reilo/flip4fun-neopixel/README.md

# Ambilight multi-color effects for pinball machines

## Motivation and Summary

Goal of this project is to add multi-color ambilight effects to pinball machines. Instead of showing static colors the lighting effects should depend on the current gameplay situation such as the active mission, the currently running multiball or any other events.

The used hardware consists of LED strips which are attached below the cabinet and behind the backbox, both to the left and right side. The strips are controlled by a microcontroller, an Arduino Uno in this case.

The actual challenge of the project is to find out the current gameplay situation. Unfortunately pinball manufacturers do not provide any APIs for their machines. The only way is to read the state of coils, flashers, and lamps by sensors. For flashers and coils this could be  done directly by measuring the electric current from the  board connectors. Accessing the multiplexed lamp matrix however seems to be hardly feasible.

As I am not an electronics engineer and won't risk to disturb the sensitive pinball electronics I decided to simply read the state of lamps and flashers from below the playfield using photo sensors.

Version 1.0 is now ready - check out this [YouTube video](https://www.youtube.com/watch?v=rxIm8FgeuAI) to watch my Star Trek Pro pinball machine with ambilight.

## Hardware

### LED strips

The Neopixel multi-color LED strips allow controlling each pixel individually and the strips can easily be programmed using a microcontroller with help of the Neopixel C++ library.

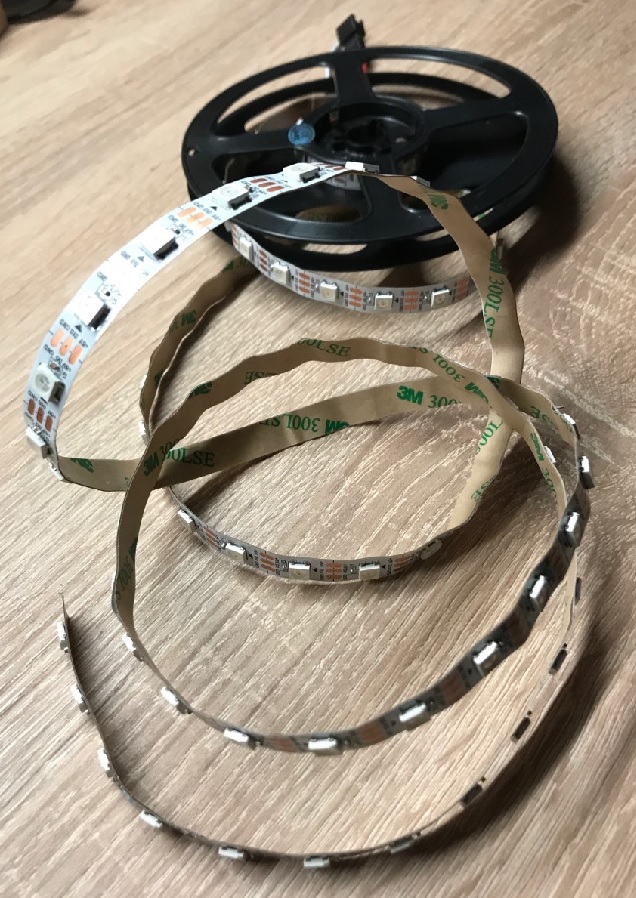
[picture p1: pictures/Neopixel-Strip.jpg]
Neopixel LED Strip


Two long LED strips are attached to either side below the cabinet and two shorter LED strips to either side behind the backbox.

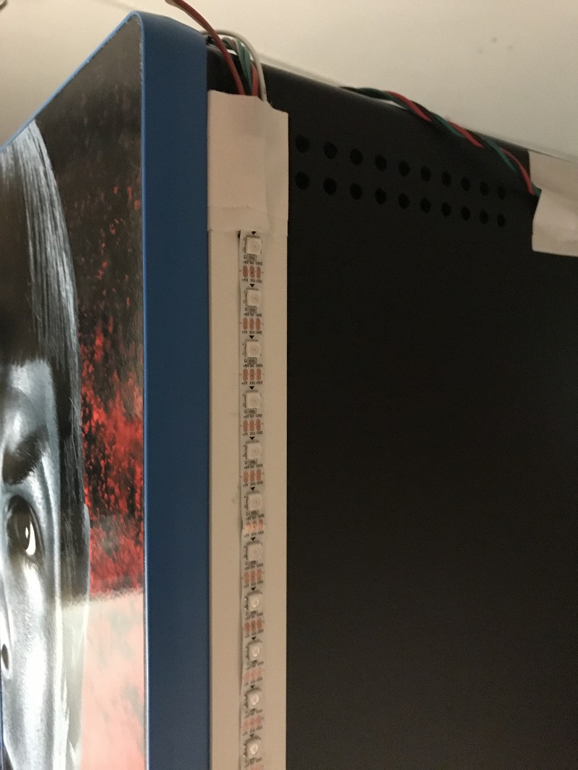
[picture p2: pictures/Backbox-LED-Strip.jpg]
Backbox LED Strip


The backbox strips are wired through the little hole on the top of the backbox which is present on all newer Stern pinball machines. The undercab strips are wired through one of the holes at the rear of the cabinet.

The DIN (digital in) port is directly connected to a digital output port of the microcontroller. The power supply ports 5VDC and GND are connected to the 5V power supply unit.

### Photo Sensors

LM393 boards are used which are integrated with a photo sensor and a potentiometer.

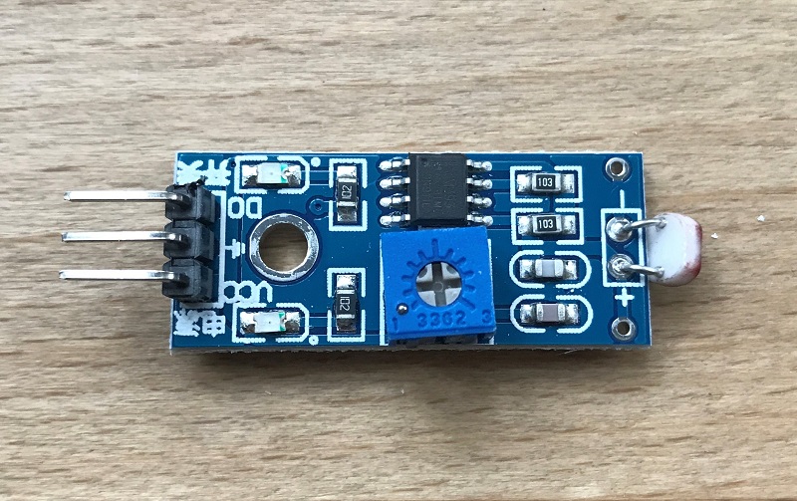
[picture p3: pictures/LM393-Photo-Sensor.jpg]
LM393 Photo Sensor


The sensor is placed below the playfield beneath the insert whose lighting state should be read. The example shows how sensors were placed below the mission inserts of Star Trek.

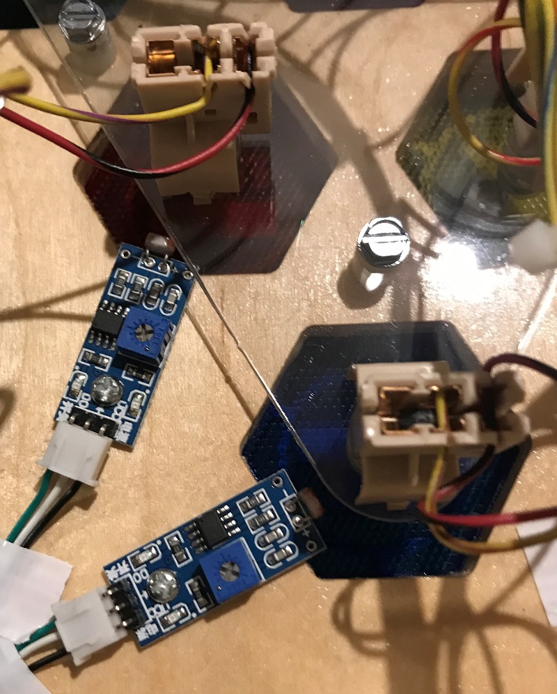
[picture p4: pictures/Playfield-Sensors-Details.jpg]
Playfield Sensors Details


The potentiometers allow to fine-tune the sensitivity of each photo sensor and avoid that any sensor is triggered erroneously from the lighting of a another nearby sensor.

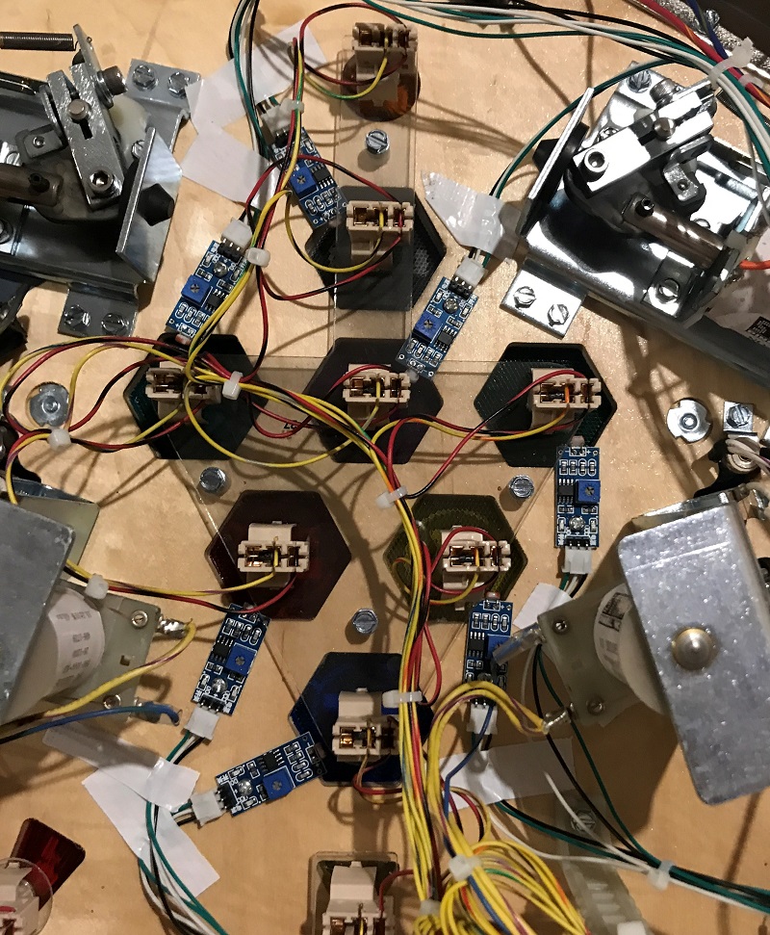
[picture p5: pictures/Playfield-Sensors.jpg]
Playfield Sensors


### Arduino Uno

The Arduino microcontroller is attached wtihin the backbox directly below the already built-in original boards. Fortunately as I am modding a SAM system there is enough space available. A shield with clamps for easy installation is additionally applied to the Arduino.

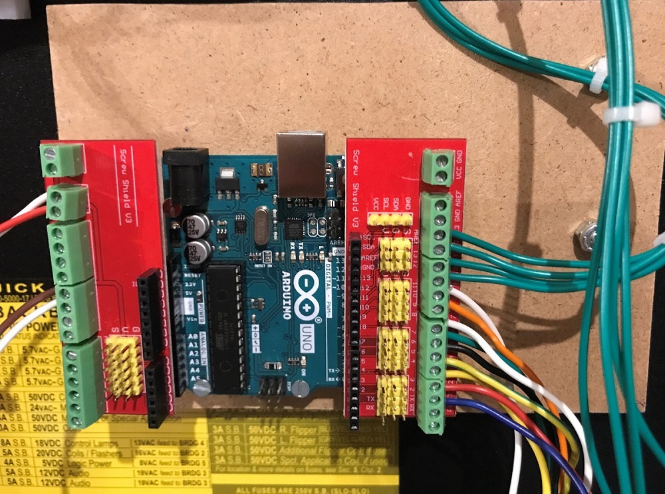
[picture p6: pictures/Arduino-Connections.jpg]
Arduino


4 digital ports (10-13) are used to feed the Neopixel strips and 9 ports (1-9) to read the sensor outputs. For this showcase project the Arduino Uno provides a sufficient number of ports but for larger scaled project with more sensors involved an Arduino Mega might be a better choice.

### 5V Power Supply

A separate 5V power supply unit has been installed within the backbox and connected directly to the 220V connector of the pinball machine.

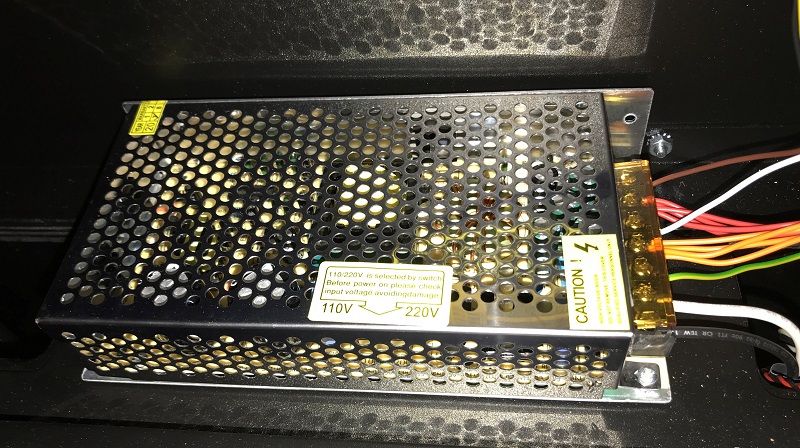
[picture p7: pictures/5V-Power-Supply.jpg]
5V Power Supply


Both Arduino and LED strips are fed from this power supply. Note that one single Neopixel LED consumes up to 63mA. This may result in worst - as about 200 LEDs are installed in this project - in a maximum of about 12A.

### Setup and Wiring

The complete backbox setup is shown below - it easily fits into the backbox of a SAM platform based machine. Plug connectors are used for all connections, so I can quickly mount or unmount my hardware or detach the backbox from the cabinet. As usual I ran out of proper wire colors - that's the reason for the weird wiring.

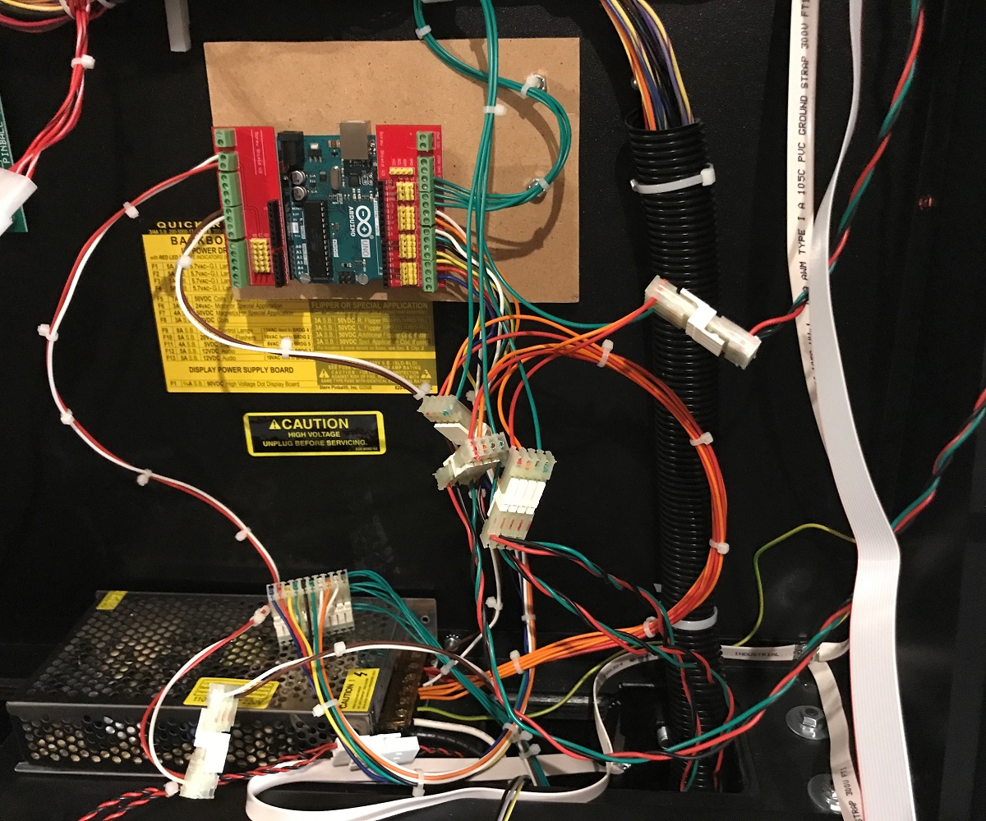
[picture p8: pictures/Backbox-Setup.jpg]
Backbox Setup


The wiring below the playfield is a challenge - I needed to follow the already existing wiring paths.

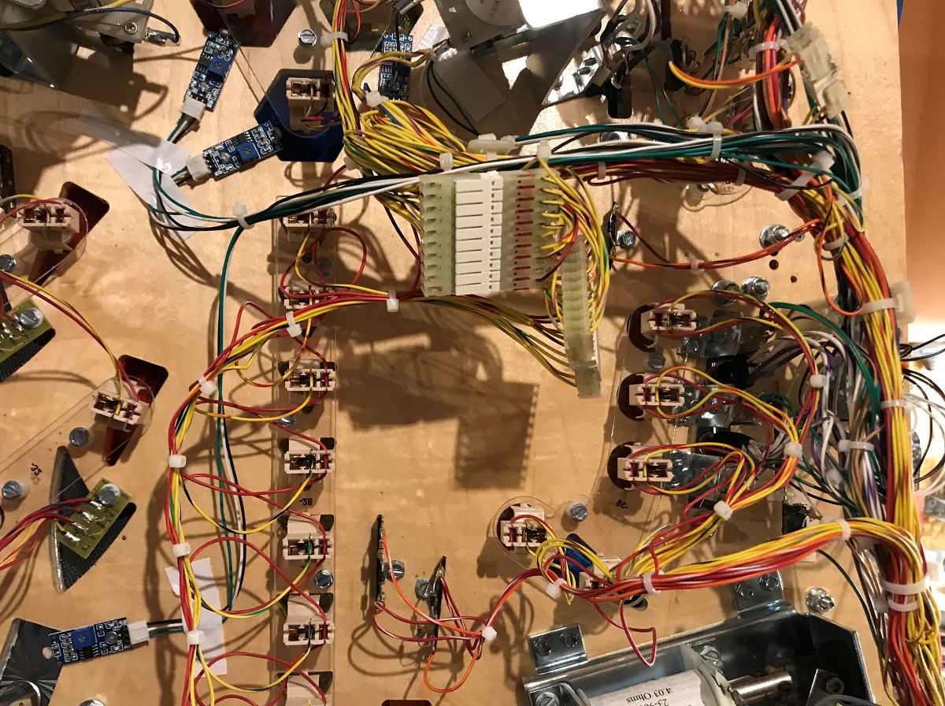
[picture p9: pictures/Playfield-Wiring-Challenge.jpg]
Playfield Wiring


The bunch of cable for the sensors' power supply and output signals is routed to the back of the playfield and further up to the backbox from below.

### Budget

Only branded product items from German shops were used. You may spend only a half or less of money if you fine-tune your expenses and buy clones from Fareast Asian shops.

Rough estimation:

- Arduino Uno microcontroller: 20 EUR
- Arduino shield: 10 EUR
- Neopixel strips: 20 EUR
- 5V power supply: 15 EUR
- Photo sensors, 9 pieces: 15 EUR
- Wiring and connectors: 15 EUR

Total budget around 95 EUR.

[powersupply]: https://github.com/reilo/flip4fun-neopixel/blob/main/pictures/5V-Power-Supply.jpg?raw=true

[arduinoconnections]: https://github.com/reilo/flip4fun-neopixel/blob/main/pictures/Arduino-Connections.jpg?raw=true

[backboxledstrip]: https://github.com/reilo/flip4fun-neopixel/blob/main/pictures/Backbox-LED-Strip.jpg?raw=true

[backboxwiring]: https://github.com/reilo/flip4fun-neopixel/blob/main/pictures/Backbox-Setup.jpg?raw=true

[photosensor]: https://github.com/reilo/flip4fun-neopixel/blob/main/pictures/LM393-Photo-Sensor.jpg?raw=true

[neopixelstrip]: https://github.com/reilo/flip4fun-neopixel/blob/main/pictures/Neopixel-Strip.jpg?raw=true

[playfieldsensors]: https://github.com/reilo/flip4fun-neopixel/blob/main/pictures/Playfield-Sensors.jpg?raw=true

[playfieldsensorsdetails]: https://github.com/reilo/flip4fun-neopixel/blob/main/pictures/Playfield-Sensors-Details.jpg?raw=true 

[playfieldwiring]: https://github.com/reilo/flip4fun-neopixel/blob/main/pictures/Playfield-Wiring-Challenge.jpg?raw=true

## Software

May come later. For now refer to the source code.
