reilo/flip4fun-neopixel/(commit log)

2020-10-11 Sample scripts added
2020-10-11 Fixes and sample extended
    [playground.ino]
2020-10-13 Added switchers to determine blinking inserts
2020-10-20 Prepared multi switcher
